jhonney13/Mouse-Firmware-PCB/Mouse Firmware/pcb/README.md

# Mouse PCB
Repository for the mouse circuit board schematics.

Some of the features are:
- PMW3360DM sensor
- STM32F042K6T6 MCU
- Hardware debouncing
- Expansion pins for future upgrades
- USB-C
