jhonney13/Mouse-Firmware-PCB/Mouse Firmware/pcb/3d/encoder_ec10_9mm.step

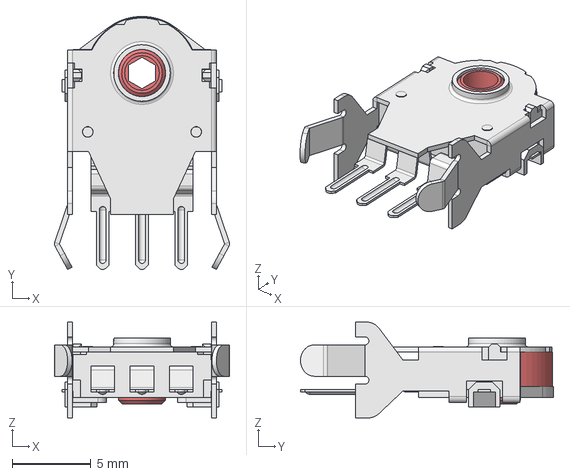
[picture p1: CAD file, 2024-11-30]
Mouse Firmware/pcb/3d/encoder_ec10_9mm.step
11.1 x 16.1 x 6.10 mm
