jhonney13/Mouse-Firmware-PCB/Mouse Firmware/pcb/3d/sensor_pmw3360dm.step

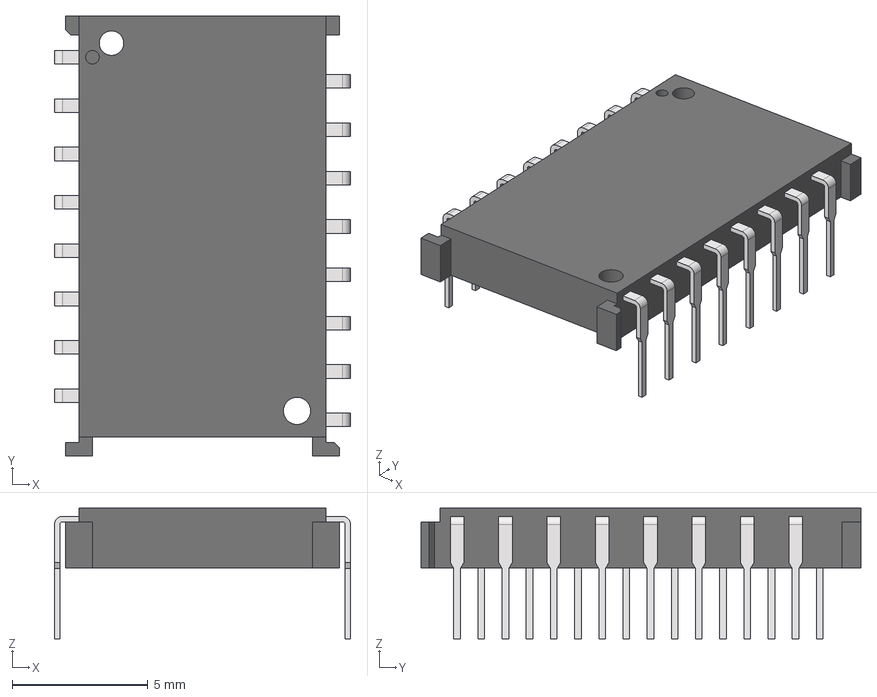
[picture p2: CAD file, 2024-11-30]
Mouse Firmware/pcb/3d/sensor_pmw3360dm.step
10.9 x 16.2 x 4.81 mm
Lead x 8
Lead(Mirror) x 8
