jhonney13/Mouse-Firmware-PCB/Mouse Firmware/pcb/3d/switch_d2fc-f-7n.step

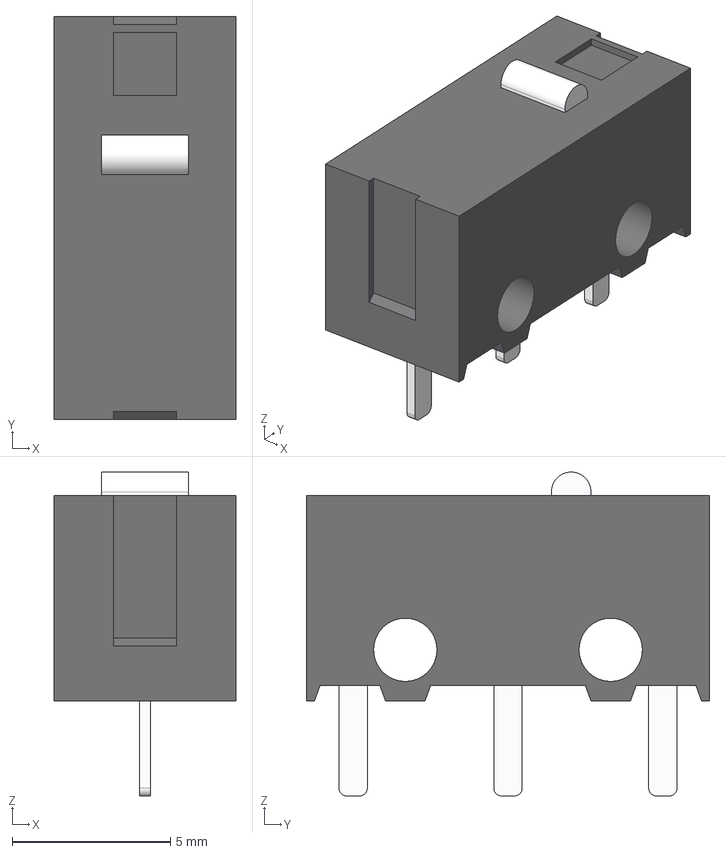
[picture p3: CAD file, 2024-11-30]
Mouse Firmware/pcb/3d/switch_d2fc-f-7n.step
5.75 x 12.8 x 10.2 mm
Switch Body
Pin 2
Button
Pin 3
Pin 1
