jhonney13/Mouse-Firmware-PCB/Mouse Firmware/pcb/3d/usb_c_u262-16xn-4bvc11.step

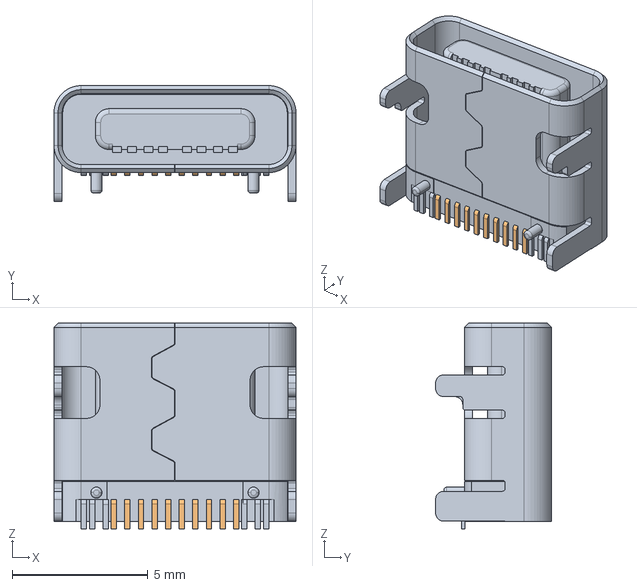
[picture p4: CAD file, 2024-11-30]
Mouse Firmware/pcb/3d/usb_c_u262-16xn-4bvc11.step
8.90 x 4.26 x 7.56 mm
