jhonney13/Mouse-Firmware-PCB/Mouse Firmware/pcb/mouse.kicad_pcb

## KiCad design Mouse Firmware/pcb/mouse.kicad_pcb (2024-11-30)

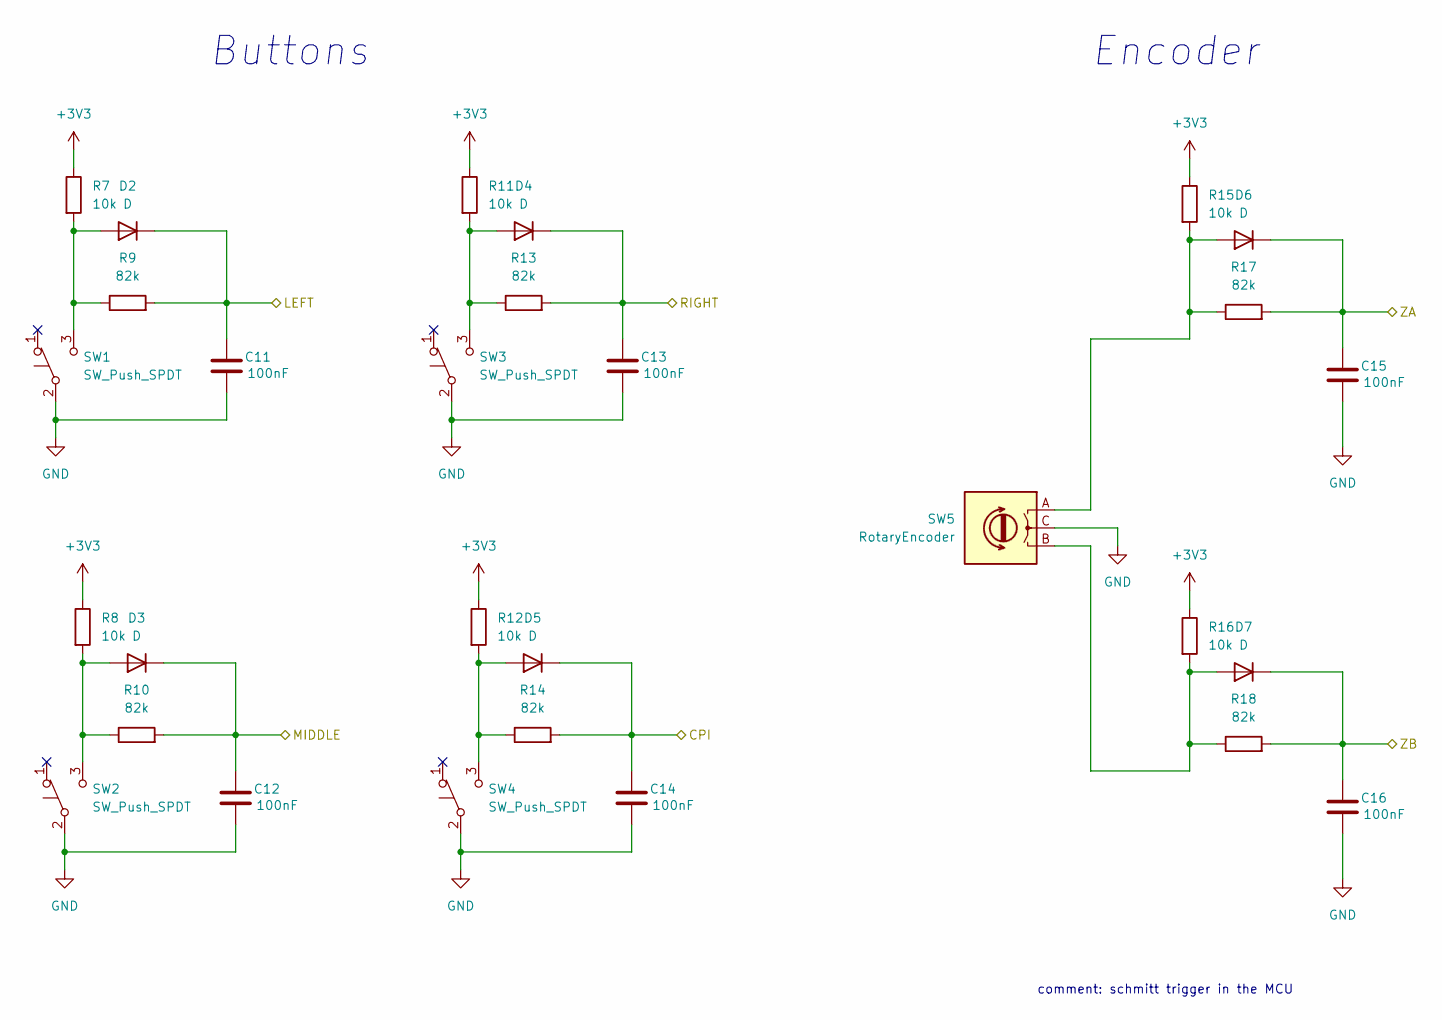
[picture p5: schematic buttons.kicad_sch]

Parts:
C11, C12, C13, C14, C15, C16: 100nF; C_0603_1608Metric; LCSC C14663
D2, D3, D4, D5, D6, D7: D; D_SOD-123F; LCSC C64898
R7, R8, R11, R12, R15, R16: 10k; R_0603_1608Metric; LCSC C25804
R9, R10, R13, R14, R17, R18: 82k; R_0603_1608Metric; LCSC C23254
SW1, SW2, SW3, SW4: SW_Push_SPDT; mouse_switch
SW5: RotaryEncoder; mouse_encoder

Connections:
+3V3: R7.1, R8.1, R11.1, R12.1, R15.1, R16.1; also elsewhere on the board
/buttons/CPI: C14.1, D5.1 (K), R14.2; also elsewhere on the board
/buttons/LEFT: C11.1, D2.1 (K), R9.2; also elsewhere on the board
/buttons/MIDDLE: C12.1, D3.1 (K), R10.2; also elsewhere on the board
/buttons/RIGHT: C13.1, D4.1 (K), R13.2; also elsewhere on the board
/buttons/ZA: C15.1, D6.1 (K), R17.2; also elsewhere on the board
/buttons/ZB: C16.1, D7.1 (K), R18.2; also elsewhere on the board
GND: C11.2, C12.2, C13.2, C14.2, C15.2, C16.2, SW1.2 (B), SW2.2 (B), SW3.2 (B), SW4.2 (B), SW5.C; also elsewhere on the board
unnamed: D2.2 (A), R7.2, R9.1, SW1.3 (C)
unnamed: D3.2 (A), R8.2, R10.1, SW2.3 (C)
unnamed: D4.2 (A), R11.2, R13.1, SW3.3 (C)
unnamed: D5.2 (A), R12.2, R14.1, SW4.3 (C)
unnamed: D6.2 (A), R15.2, R17.1, SW5.A
unnamed: D7.2 (A), R16.2, R18.1, SW5.B

Notes on the sheet:
Encoder
Buttons
comment: schmitt trigger in the MCU

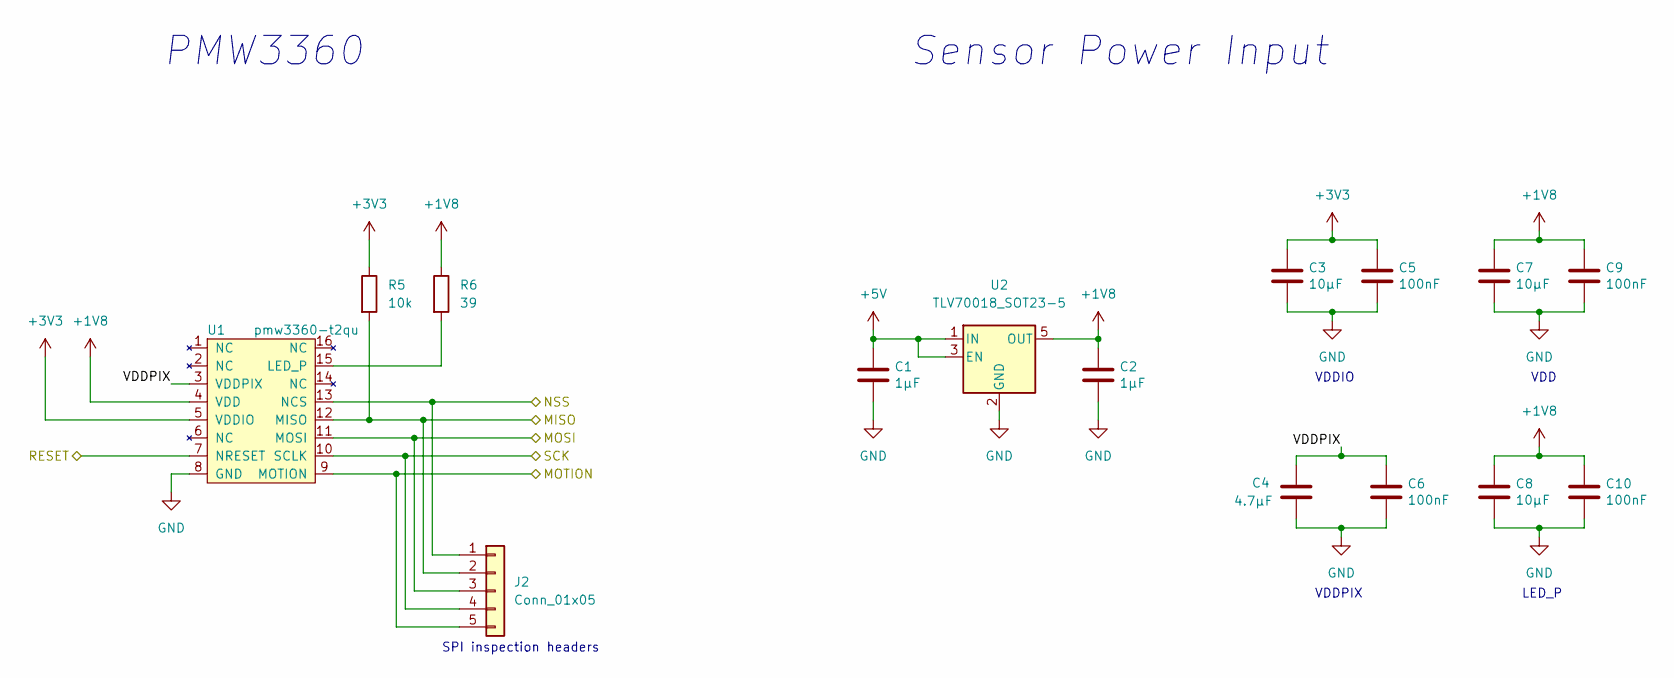
[picture p6: schematic sensor.kicad_sch]

Parts:
C1, C2: 1μF; C_0603_1608Metric; LCSC C15849
C3, C7, C8: 10μF; C_0603_1608Metric; LCSC C19702
C4: 4.7μF; C_0603_1608Metric; LCSC C19666
C5, C6, C9, C10: 100nF; C_0603_1608Metric; LCSC C14663
J2: Conn_01x05; PinHeader_1x05_P2.54mm_Vertical
R5: 10k; R_0603_1608Metric; LCSC C25804
R6: 39; R_0603_1608Metric; LCSC C227890
U1: pmw3360-t2qu
U2: TLV70018_SOT23-5; SOT-23-5; LCSC C79924

Connections:
+1V8: C2.1, C7.1, C8.1, C9.1, C10.1, R6.1, U1.4 (VDD), U2.5 (OUT)
+3V3: C3.1, C5.1, R5.1, U1.5 (VDDIO); also elsewhere on the board
+5V: C1.1, U2.1 (IN), U2.3 (EN); also elsewhere on the board
/mcu/SENSOR_MISO: J2.2, R5.2, U1.12 (MISO); also elsewhere on the board
/mcu/SENSOR_MOSI: J2.3, U1.11 (MOSI); also elsewhere on the board
/mcu/SENSOR_MOTION: J2.5, U1.9 (MOTION); also elsewhere on the board
/mcu/SENSOR_NSS: J2.1, U1.13 (NCS); also elsewhere on the board
/mcu/SENSOR_RESET: U1.7 (NRESET); also elsewhere on the board
/mcu/SENSOR_SCK: J2.4, U1.10 (SCLK); also elsewhere on the board
/sensor/VDDPIX: C4.1, C6.1, U1.3 (VDDPIX)
GND: C1.2, C2.2, C3.2, C4.2, C5.2, C6.2, C7.2, C8.2, C9.2, C10.2, U1.8 (GND), U2.2 (GND); also elsewhere on the board
unnamed: R6.2, U1.15 (LED_P)

Notes on the sheet:
VDDIO
VDD
SPI inspection headers
Sensor Power Input
LED_P
VDDPIX
PMW3360

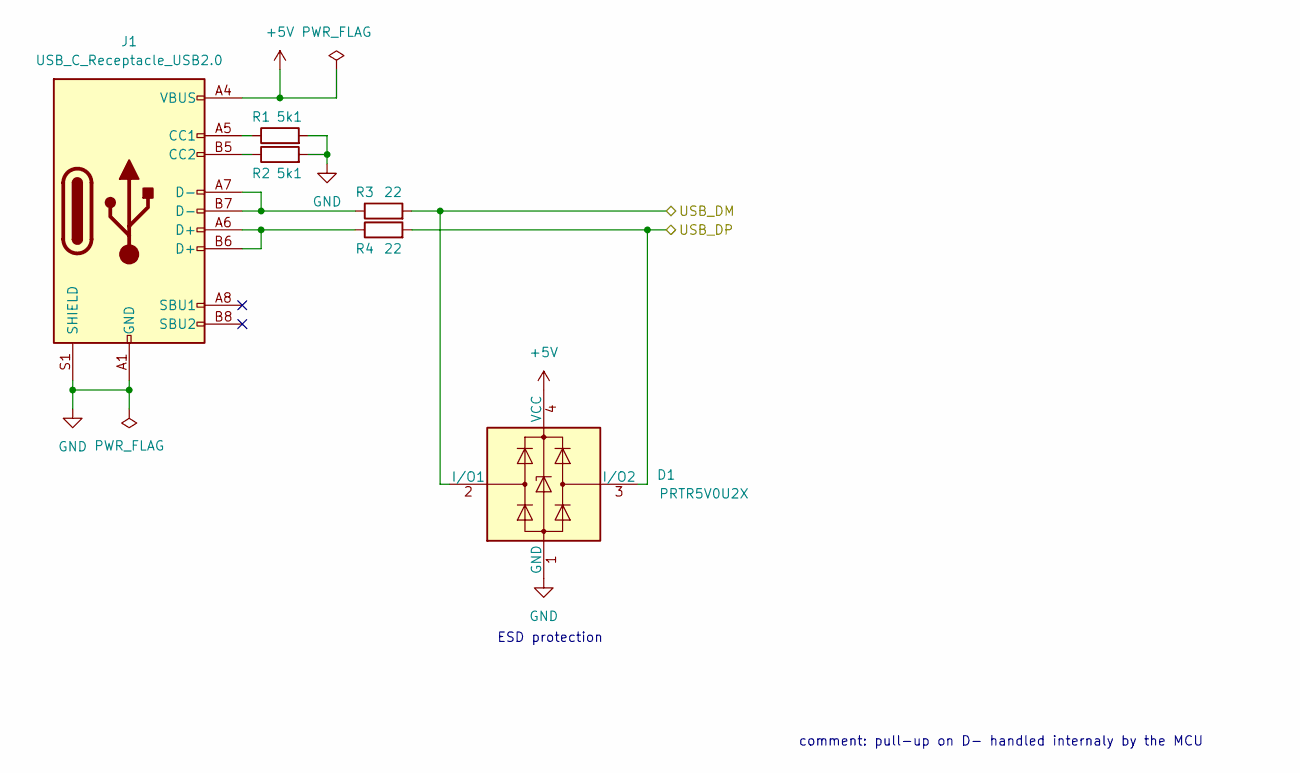
[picture p7: schematic usb.kicad_sch]

Parts:
D1: PRTR5V0U2X; SOT-143; LCSC C2827688
J1: USB_C_Receptacle_USB2.0; USB_C_Receptacle_XKB_U262-16XN-4BVC11; LCSC C319148
R1, R2: 5k1; R_0603_1608Metric; LCSC C23186
R3, R4: 22; R_0603_1608Metric; LCSC C107701

Connections:
+5V: D1.4 (VCC), J1.A4 (VBUS), J1.A9 (VBUS), J1.B4 (VBUS), J1.B9 (VBUS); also elsewhere on the board
/mcu/USB_DM: D1.2 (I/O1), R3.2; also elsewhere on the board
/mcu/USB_DP: D1.3 (I/O2), R4.2; also elsewhere on the board
GND: D1.1 (GND), J1.A1 (GND), J1.A12 (GND), J1.B1 (GND), J1.B12 (GND), J1.S1 (SHIELD), R1.2, R2.2; also elsewhere on the board
unnamed: J1.A5 (CC1), R1.1
unnamed: J1.A6 (D+), J1.B6 (D+), R4.1
unnamed: J1.A7 (D-), J1.B7 (D-), R3.1
unnamed: J1.B5 (CC2), R2.1

Notes on the sheet:
ESD protection
comment: pull-up on D- handled internaly by the MCU

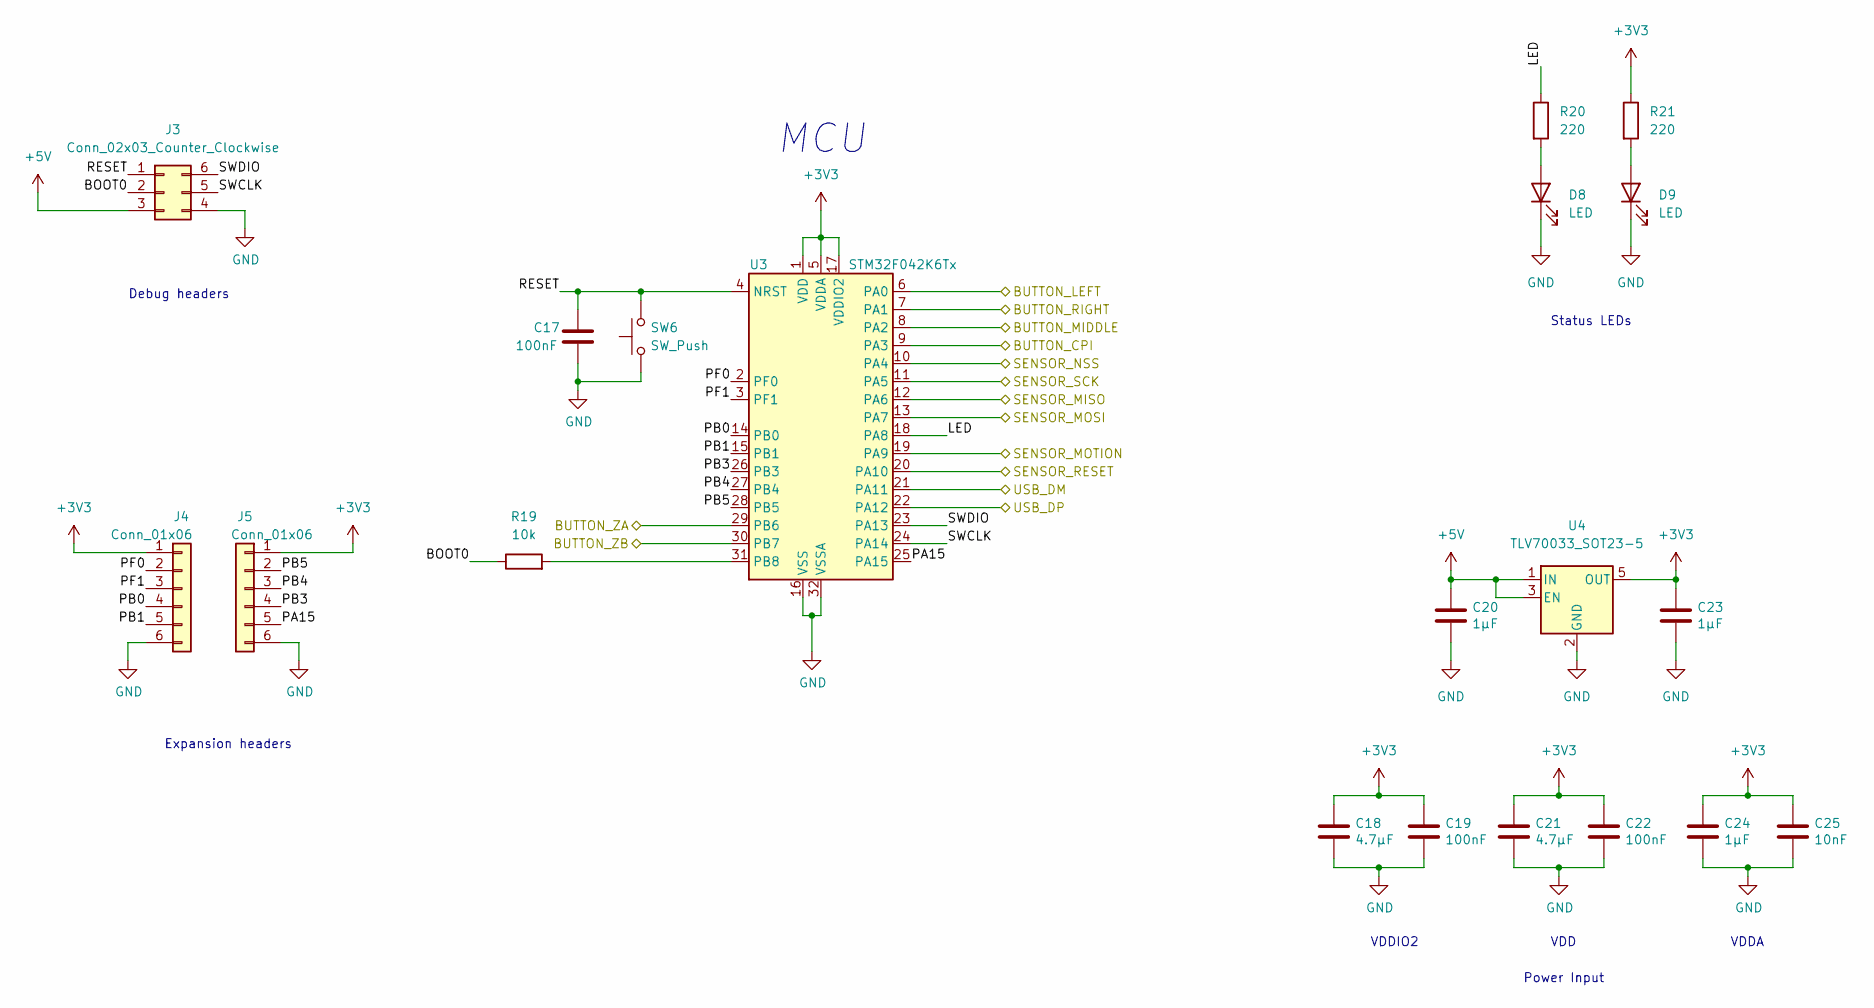
[picture p8: schematic mcu.kicad_sch]

Parts:
C17, C19, C22: 100nF; C_0603_1608Metric; LCSC C14663
C18, C21: 4.7μF; C_0603_1608Metric; LCSC C19666
C20, C23, C24: 1μF; C_0603_1608Metric; LCSC C15849
C25: 10nF; C_0603_1608Metric; LCSC C57112
D8, D9: LED; LED_0603_1608Metric; LCSC C72038
J3: Conn_02x03_Counter_Clockwise; PinHeader_2x03_P2.54mm_Vertical
J4, J5: Conn_01x06; PinSocket_1x06_P2.54mm_Vertical
R19: 10k; R_0603_1608Metric; LCSC C25804
R20, R21: 220; R_0603_1608Metric; LCSC C22962
SW6: SW_Push; SW_PUSH_6mm
U3: STM32F042K6Tx; LQFP-32_7x7mm_P0.8mm; LCSC C69216
U4: TLV70033_SOT23-5; SOT-23-5; LCSC C11337

Connections:
+3V3: C18.1, C19.1, C21.1, C22.1, C23.1, C24.1, C25.1, J4.1, J5.1, R21.1, U3.1 (VDD), U3.5 (VDDA), U3.17 (VDDIO2), U4.5 (OUT); also elsewhere on the board
+5V: C20.1, J3.3, U4.1 (IN), U4.3 (EN); also elsewhere on the board
/buttons/CPI: U3.9 (PA3); also elsewhere on the board
/buttons/LEFT: U3.6 (PA0); also elsewhere on the board
/buttons/MIDDLE: U3.8 (PA2); also elsewhere on the board
/buttons/RIGHT: U3.7 (PA1); also elsewhere on the board
/buttons/ZA: U3.29 (PB6); also elsewhere on the board
/buttons/ZB: U3.30 (PB7); also elsewhere on the board
/mcu/BOOT0: J3.2, R19.1
/mcu/LED: R20.1, U3.18 (PA8)
/mcu/PA15: J5.5, U3.25 (PA15)
/mcu/PB0: J4.4, U3.14 (PB0)
/mcu/PB1: J4.5, U3.15 (PB1)
/mcu/PB3: J5.4, U3.26 (PB3)
/mcu/PB4: J5.3, U3.27 (PB4)
/mcu/PB5: J5.2, U3.28 (PB5)
/mcu/PF0: J4.2, U3.2 (PF0)
/mcu/PF1: J4.3, U3.3 (PF1)
/mcu/RESET: C17.1, J3.1, SW6.2, U3.4 (NRST)
/mcu/SENSOR_MISO: U3.12 (PA6); also elsewhere on the board
/mcu/SENSOR_MOSI: U3.13 (PA7); also elsewhere on the board
/mcu/SENSOR_MOTION: U3.19 (PA9); also elsewhere on the board
/mcu/SENSOR_NSS: U3.10 (PA4); also elsewhere on the board
/mcu/SENSOR_RESET: U3.20 (PA10); also elsewhere on the board
/mcu/SENSOR_SCK: U3.11 (PA5); also elsewhere on the board
/mcu/SWCLK: J3.5, U3.24 (PA14)
/mcu/SWDIO: J3.6, U3.23 (PA13)
/mcu/USB_DM: U3.21 (PA11); also elsewhere on the board
/mcu/USB_DP: U3.22 (PA12); also elsewhere on the board
GND: C17.2, C18.2, C19.2, C20.2, C21.2, C22.2, C23.2, C24.2, C25.2, D8.1 (K), D9.1 (K), J3.4, J4.6, J5.6, SW6.1, U3.16 (VSS), U3.32 (VSSA), U4.2 (GND); also elsewhere on the board
unnamed: D8.2 (A), R20.2
unnamed: D9.2 (A), R21.2
unnamed: R19.2, U3.31 (PB8)

Notes on the sheet:
Power Input
VDD
MCU
Debug headers
VDDIO2
Status LEDs
VDDA
Expansion headers

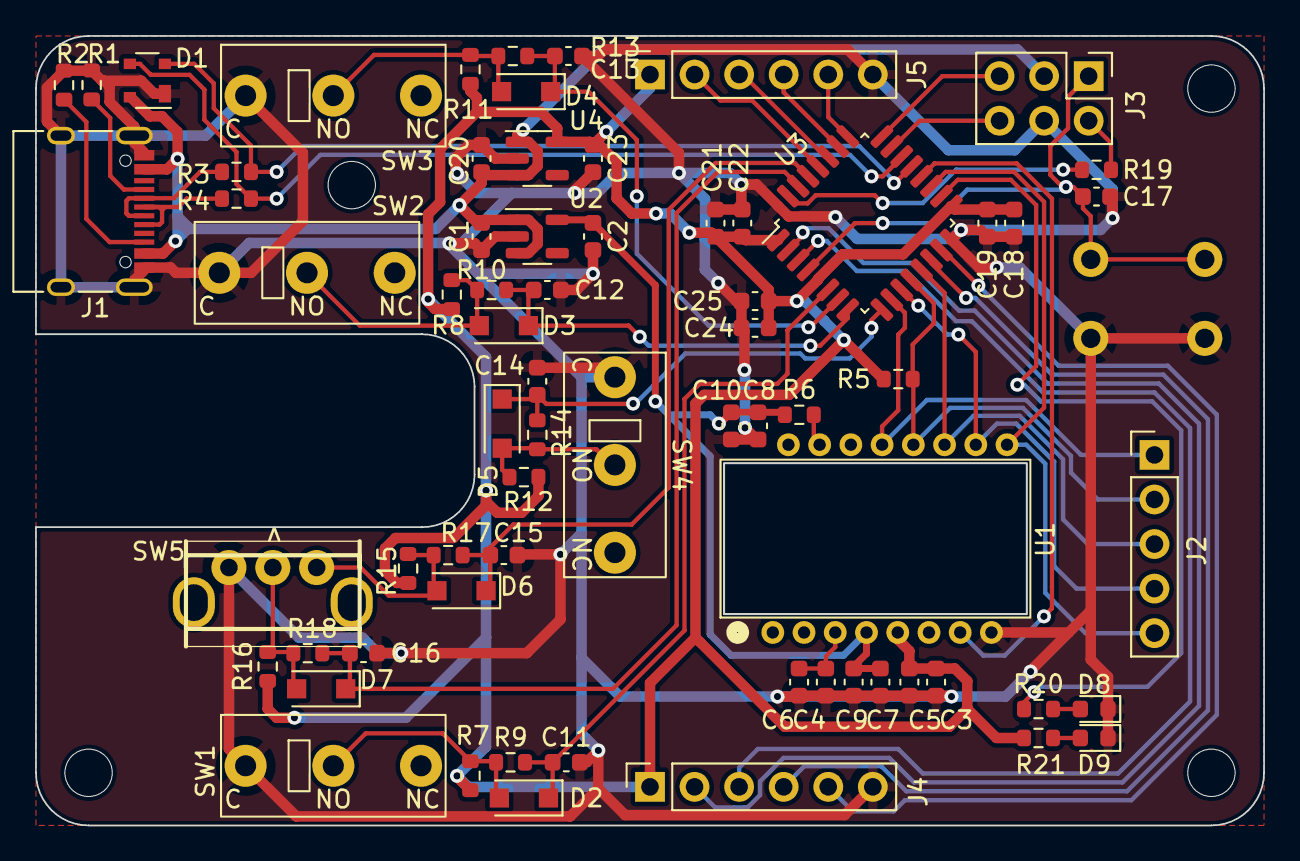
[picture p9: board mouse.kicad_pcb from above]

Board: 2 copper layers, 70.0 x 45.0 mm, 70 parts (1 on the bottom side), 46 nets.
