jhonney13/Mouse-Firmware-PCB/Mouse Firmware/firmware-c/hal/stm32/common/pins.h

#ifndef HAL_PINS_H
#define HAL_PINS_H

#include <libopencm3/stm32/gpio.h>
#include <libopencm3/stm32/rcc.h>
#include <stdint.h>

typedef struct port_pin {
  uint32_t port;
  uint32_t pin;
  uint32_t rcc;
} io_t;

#define PORT_PIN(port, pin, rcc) \
  (io_t) { port, pin, rcc }
#define PORT(port_pin) port_pin.port
#define PIN(port_pin) port_pin.pin
#define RCC_PORT(port_pin) port_pin.rcc

#define IO_A0 PORT_PIN(GPIOA, GPIO0, RCC_GPIOA)
#define IO_A1 PORT_PIN(GPIOA, GPIO1, RCC_GPIOA)
#define IO_A2 PORT_PIN(GPIOA, GPIO2, RCC_GPIOA)
#define IO_A3 PORT_PIN(GPIOA, GPIO3, RCC_GPIOA)
#define IO_A4 PORT_PIN(GPIOA, GPIO4, RCC_GPIOA)
#define IO_A5 PORT_PIN(GPIOA, GPIO5, RCC_GPIOA)
#define IO_A6 PORT_PIN(GPIOA, GPIO6, RCC_GPIOA)
#define IO_A7 PORT_PIN(GPIOA, GPIO7, RCC_GPIOA)
#define IO_A8 PORT_PIN(GPIOA, GPIO8, RCC_GPIOA)
#define IO_A9 PORT_PIN(GPIOA, GPIO9, RCC_GPIOA)
#define IO_A10 PORT_PIN(GPIOA, GPIO10, RCC_GPIOA)
#define IO_A11 PORT_PIN(GPIOA, GPIO11, RCC_GPIOA)
#define IO_A12 PORT_PIN(GPIOA, GPIO12, RCC_GPIOA)
#define IO_A13 PORT_PIN(GPIOA, GPIO13, RCC_GPIOA)
#define IO_A14 PORT_PIN(GPIOA, GPIO14, RCC_GPIOA)
#define IO_A15 PORT_PIN(GPIOA, GPIO15, RCC_GPIOA)

#define IO_B0 PORT_PIN(GPIOB, GPIO0, RCC_GPIOB)
#define IO_B1 PORT_PIN(GPIOB, GPIO1, RCC_GPIOB)
#define IO_B2 PORT_PIN(GPIOB, GPIO2, RCC_GPIOB)
#define IO_B3 PORT_PIN(GPIOB, GPIO3, RCC_GPIOB)
#define IO_B4 PORT_PIN(GPIOB, GPIO4, RCC_GPIOB)
#define IO_B5 PORT_PIN(GPIOB, GPIO5, RCC_GPIOB)
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
#define IO_K11 PORT_PIN(GPIOK, GPIO11, RCC_GPIOK)
#define IO_K12 PORT_PIN(GPIOK, GPIO12, RCC_GPIOK)
#define IO_K13 PORT_PIN(GPIOK, GPIO13, RCC_GPIOK)
#define IO_K14 PORT_PIN(GPIOK, GPIO14, RCC_GPIOK)
#define IO_K15 PORT_PIN(GPIOK, GPIO15, RCC_GPIOK)

#endif
